crpistillo/ProyectoDCE/README.md

# ProyectoDCE

Los archivos correspondientes a la Primera entrega: TP1 - Etapa de control se encuentran en el directorio *PROYECTO_ETAPA_CONTROL*
