crpistillo/ProyectoDCE/PRACTICAS/P-2 Ejercicio fuente conmutada/P_2_DCE.pdf

Universidad de Buenos Aires

Facultad de Ingeniería

1

er Cuatrimestre 2019

Diseno de Circuitos Electr ˜ | onicos (86.10) ´

## Actividad 2

Tema: Fuentes Conmutadas
Fecha: 8 de mayo de 2020

Grupo 4 - Integrantes:

Apellido y Nombre | Padrón | Correo Electrónico
Galli, Joaquin | 99793 | jgalli@fi.uba.ar
Pereyra, Matias Nicolas | 99362 | mnpereyra@fi.uba.ar
Pistillo, Carolina Rocío | 99177 | cpistillo@fi.uba.ar
Scharn, Ignacio | 98399 | ischarn@fi.uba.ar

Resumen
El objetivo de esta actividad fue estudiar tanto analíticamente como por simulación el comportamiento de un circuito que implementa fuentes conmutadas. Se deseará en particular determinar la tensión sobre el capacitor a la salida en régimen permanente. Finalmente se compararon los resultados obtenidos mediante ambos métodos.

## 1. Circuito propuesto

Para el circuito de la Figura 1 se desea determinar la tensión sobre el capacitor C1 en régimen permamente. Se considerarán C1 y L1 inicialmente descargados y se despreciarán las caídas de tensión en R1 a R5 y en RDS.

Es interesante notar también que la corriente promedio en el inductor durante su energizado disminuirá a medida que crece la tensión en el capacitor C1 debido a que la tensión efectiva aplicada al inductor (durante su energizado) siempre será V 1 − V C1. También disminuirá el tiempo de descarga de la energía del inductor a medida que va aumentando la tensión VC1 en el capacitor por lo que el circuito comienza operando en modo continuo y gradualmente va pasando al modo discontinuo.

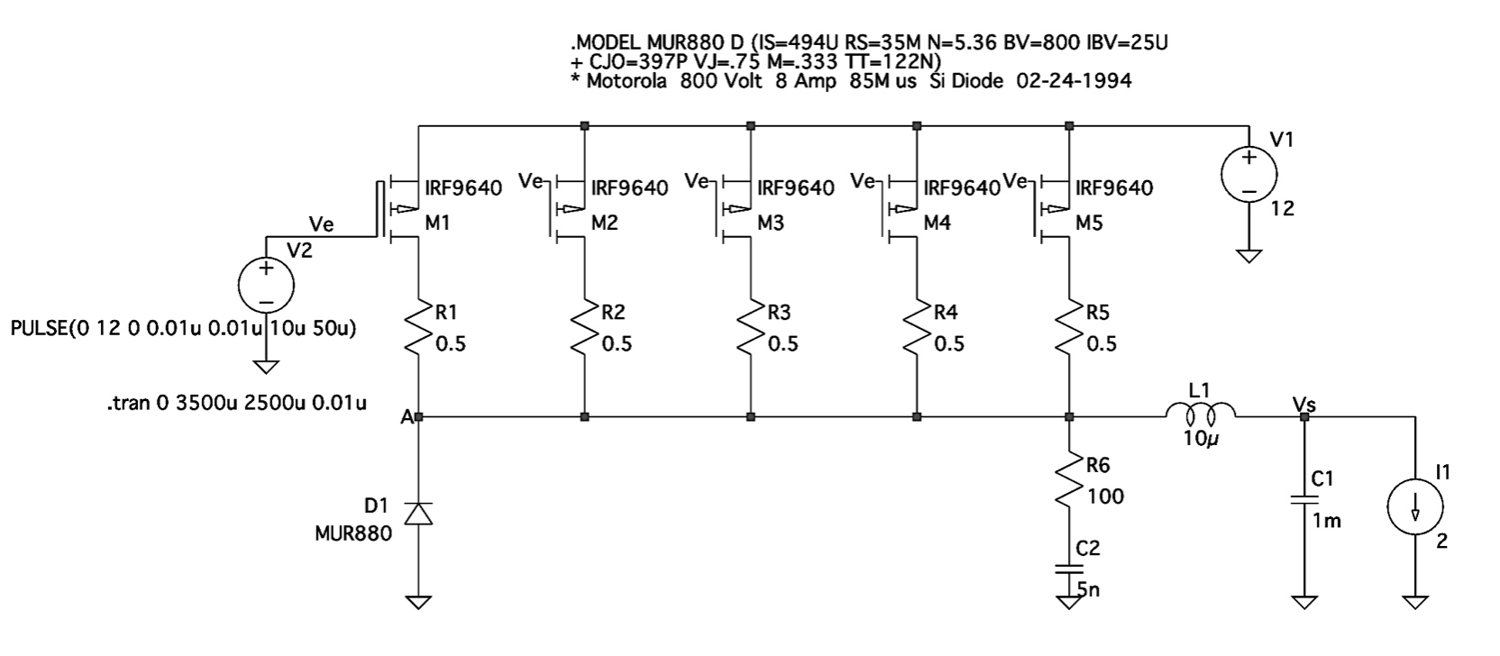
[picture p28: figure]

Figura 1: Simulación del circuito propuesto de fuentes conmutadas realizado en LTspice

Para la corriente sobre el diodo D1 se tendrá en cuenta la Figura 2 que muestra dicho valor en función de la tensión para el modelo MUR880.

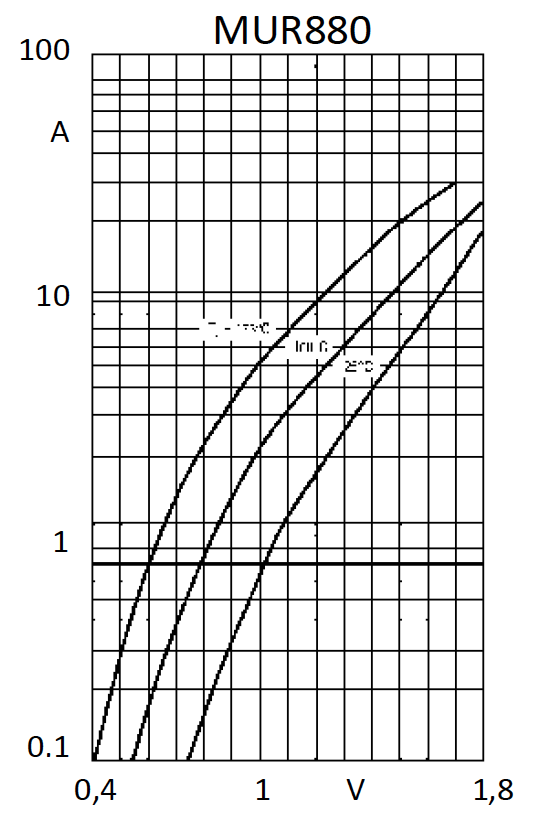
[picture p29: figure]

Figura 2: Curva I-V para el modelo de diodo MUR880

1

## 2. Análisis circuital

A continuación se procederá a analizar el circuito durante los dos estados de conmutación posibles del mismo.

Llave 1 cerrada y llave 2 abierta

Cuando la tensión del generador esta en 0 V, la tensión VGS de los P-MOSFET será de -12 V. Esto los coloca en saturación y hace que se comporten como llaves cerradas, permitiendo el paso de los 12 V al nodo de Drain. Despreciando las caídas de tensión de R1 a R5 podemos suponer que en el nodo A habrá también 12 V. Esto deja al diodo D1 en inversa y por lo tanto no conduciendo en la primera parte del ciclo.

La corriente en la inductancia L1 comienza a elevarse cargando al inductor durante la primer parte del ciclo, llegando a un valor ILmax

. Como se sabe que el circuito termina operando en modo discontinuo, la corriente mínima en el inductor será ILmin = 0A. El capacitor C1 = 1mF tiene un valor que hará que tarde en cargarse y no permita que se lleve corriente. Puede considerarse de esta forma una corriente promedio sobre el inductor igual al valor de la fuente de corriente de 2 A.

Cuando la llave 1 esta cerrada y la llave 2 (diodo) abierta, se llega a la siguiente ecuación sobre la corriente en el inductor:

ILmax = ILmin +

(VE − VS)∆t1
L

(1)

Llave 2 cerrada y llave 1 abierta

Cuando la tensión del generador alcanza los 12 V, la tensión VGS de los P-MOSFET pasa a ser 0 V, co-locándolos en corte y haciendo que se comporten como llaves abiertas. Esto hace que ya no llegue tensión de entrada al nodo A, pero la inductancia sigue teniendo corriente. Como el diodo D1 estaba abierto, el nodo A queda puesto a una impedancia infinita y aparece una tensión en ese nodo que tendería a ir a −∞ pero al alcanzar el valor −VD pone al diodo en directa y se fija en ese valor. Este valor VD con el que se enciende el diodo se corresponderá en el gráfico de la Figura... a un valor de corriente promedio de 2A. Se tendrá entonces que VD es aproximadamente 1,1 V.

El diodo se comportará entonces como una llave que se dispara sola en la segunda parte del ciclo y la inductancia comenzará a descargarse a tensión constante. Cuando la llave 1 esta abierta y la llave 2 (diodo) esta cerrada, se llega a la siguiente ecuación sobre la corriente en el inductor:

ILmin = ILmax −

VS∆t2
L

(2)

El valor promedio de la corriente en el inductor está definido por la integral:

I =

Z T

0

i(t)dt

Dado que el inductor se carga a tensión constante, su corriente tendrá una forma triangular cuyo área bajo la curva puede calcularse fácilmente y la formula anterior se traduce a:

I =

Area
T

I =

ILmax
T

∆t1 + ∆t2
2

ILmax =

2 · I · T
∆t1 + ∆t2

(3)

Tomando la Ecuación (2) y teniendo en cuenta que para el caso discontinuo ILmin = 0A, se tiene que:

2

ILmax =

VS∆t2
L

(4)

Esta última ecuación puede expresarse en términos de VE si se recuerda que VS = VE

∆t1
∆t1+∆t2

:

ILmax =

VE · ∆t1∆t2
L · (∆t1 + ∆t2)

(5)

Igualando las expresiones de las Ecuaciones (3) y (5) se llega a:

4A · T =

VE · ∆t1 · ∆t2
L

Como los parámetros T, VE y L son de valores conocidos, se despeja en función de los mismos y se obtiene que:

∆t2 =

2 · I · T · L
VE · ∆t1

Reemplazando este valor obtenido en (3):

ILmax =

2 · I · T
∆t1 +

4A·T·L
VE·∆t1

ILmax =

2 · I · T
∆t1(1 + 4A·T·L
VE

)

(6)

Finalmente, igualando (6) y (1) se logra despejar el valor de VS en función de ∆t1:

VS =

−1
∆t

2/1(

1
2·I·T·L

+

1
VE

)

+ VE

Reemplazando por los valores conocidos se tiene que:

VS =

−1
∆t

2/1· 500MV ⁻¹

+ 12V | (7)

## 3. Simulación

En esta sección se presentan algunos resultados obtenidos por medio de la simulación del circuito de la Figura 1 mediante la herramienta LTspice.

En los siguientes gráficos se observa que el circuito se encuentra en modo discontinuo y de los puntos marcados pueden deducirse los valores del tiempo de carga ∆t1, el tiempo de descarga ∆t2 y el periodo T de la corriente en el inductor.

3

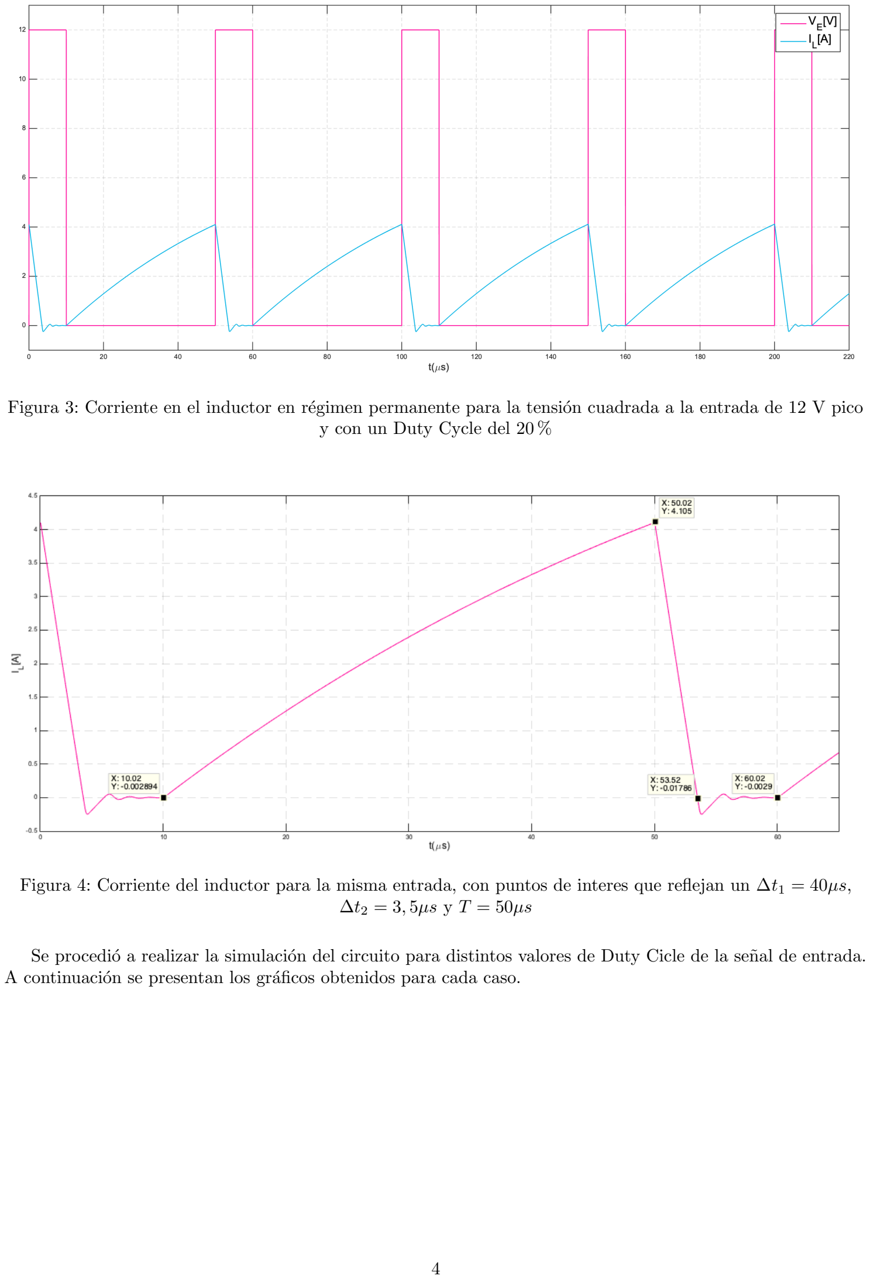
[picture p30: page 5]

Figura 3: Corriente en el inductor en régimen permanente para la tensión cuadrada a la entrada de 12 V pico y con un Duty Cycle del 20 %

Figura 4: Corriente del inductor para la misma entrada, con puntos de interes que reflejan un ∆t1 = 40µs, ∆t2 = 3, 5µs y T = 50µs

Se procedió a realizar la simulación del circuito para distintos valores de Duty Cicle de la señal de entrada. A continuación se presentan los gráficos obtenidos para cada caso.

4

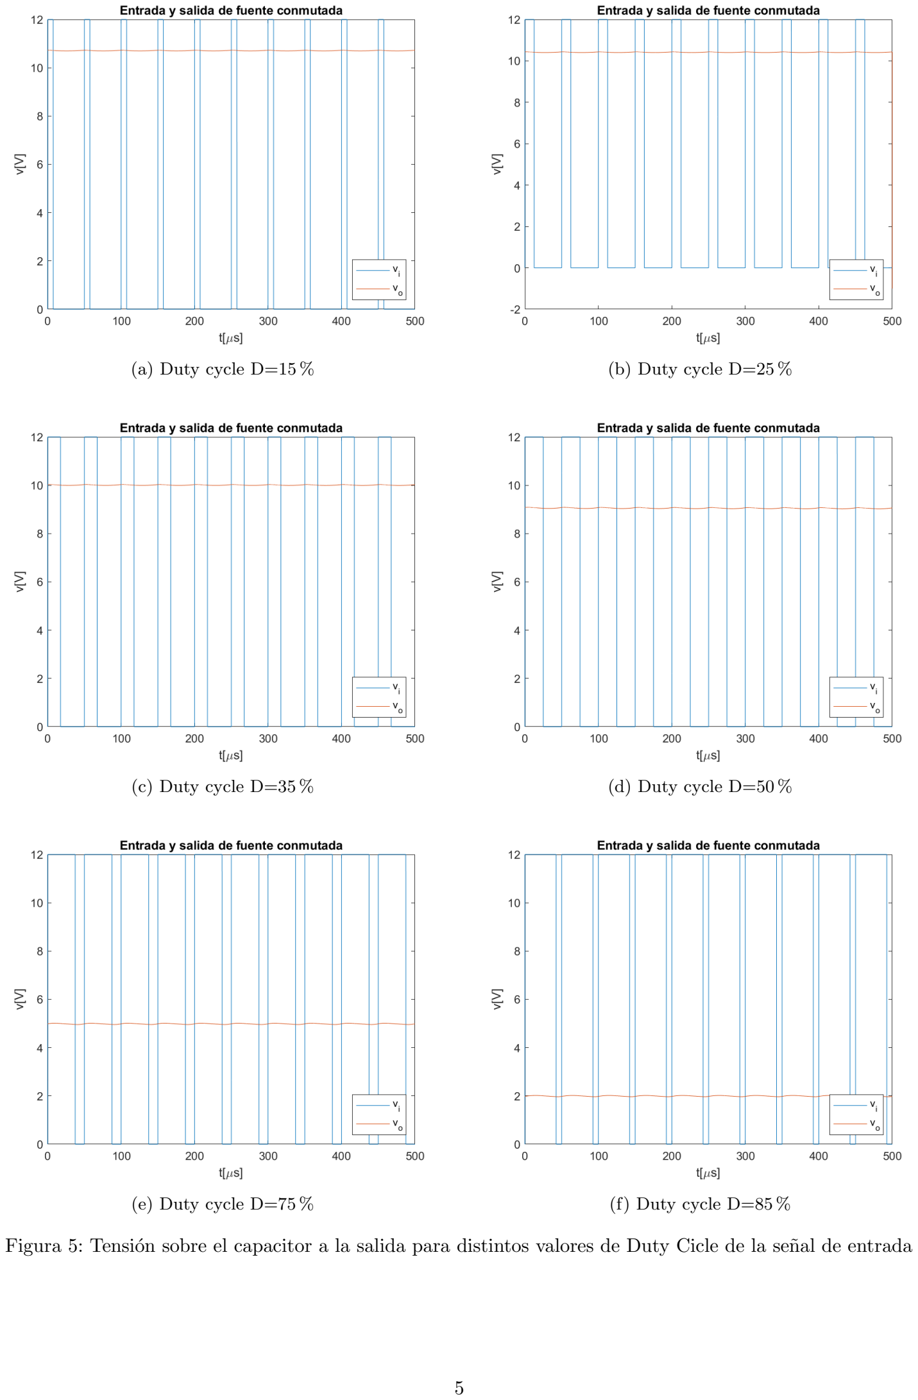
[picture p31: page 6]

(a) Duty cycle D=15 % | (b) Duty cycle D=25 %
(c) Duty cycle D=35 % | (d) Duty cycle D=50 %
(e) Duty cycle D=75 % | (f) Duty cycle D=85 %

Figura 5: Tensión sobre el capacitor a la salida para distintos valores de Duty Cicle de la señal de entrada

5

## 4. Análisis de resultados

Se calcularon además analíticamente los valores de la tensión a la salida VS a partir de la Ecuación (7) para poder observar la relación con los simulados. En el Cuadro 1 se encuentran plasmados los resultados.

D( %) | 15 | 25 | 35 | 50 | 75 | 85
∆t1(us) | 42.5 | 37 | 32.5 | 25 | 12.4 | 7.5
VS simulado(V ) | 10.74 | 10.45 | 10.15 | 9.19 | 5 | 2
VS analitico(V ) | 10.89 | 10.53 | 10.11 | 8.8 | -1 | -23.55

Cuadro 1

Puede observarse que a partir de un 50 % de Duty Cicle los resultados empiezan a diferir sustancialmente. Para valores de Duty Cicle menores que el 50 % sin embargo el comportamiento simulado es muy similar al esperado a partir de los cálculos.

6
