crpistillo/ProyectoDCE/PRACTICAS/Proyecto/Definitivo/triangular_explicada.png

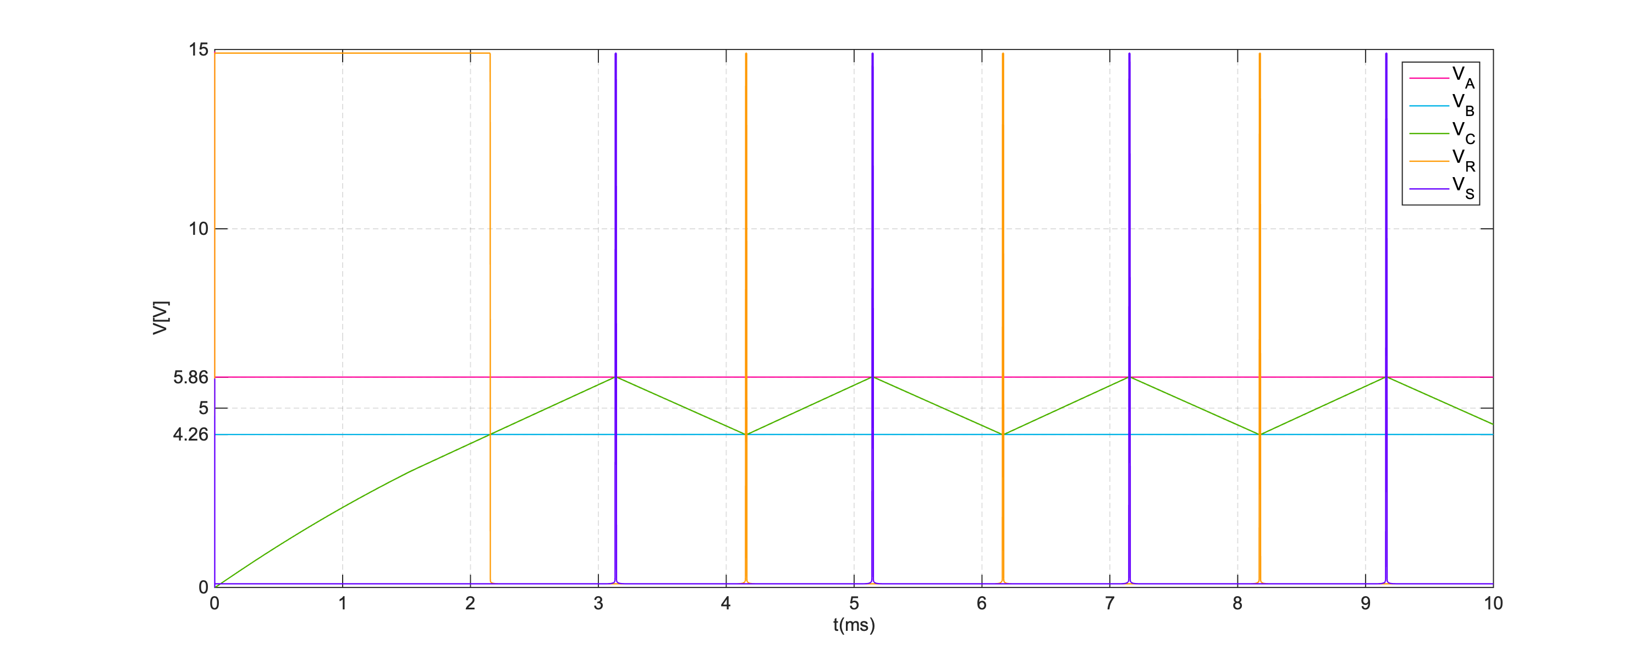
PRACTICAS/Proyecto/Definitivo/triangular_explicada.png
