crpistillo/ProyectoDCE/Kicad/Etapa_de_potencia/modelos/1N750/3D/1N750.stp

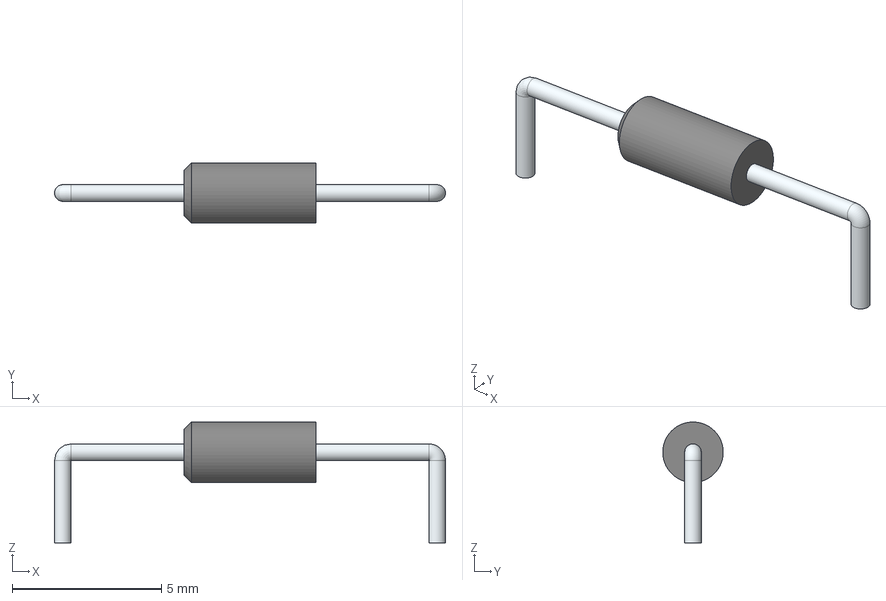
[picture p33: CAD file, 2020-07-23]
Kicad/Etapa_de_potencia/modelos/1N750/3D/1N750.stp
13.1 x 2.03 x 4.06 mm
