crpistillo/ProyectoDCE/Kicad/Etapa_de_potencia/modelos/IRF630/3D/IRF630.stp

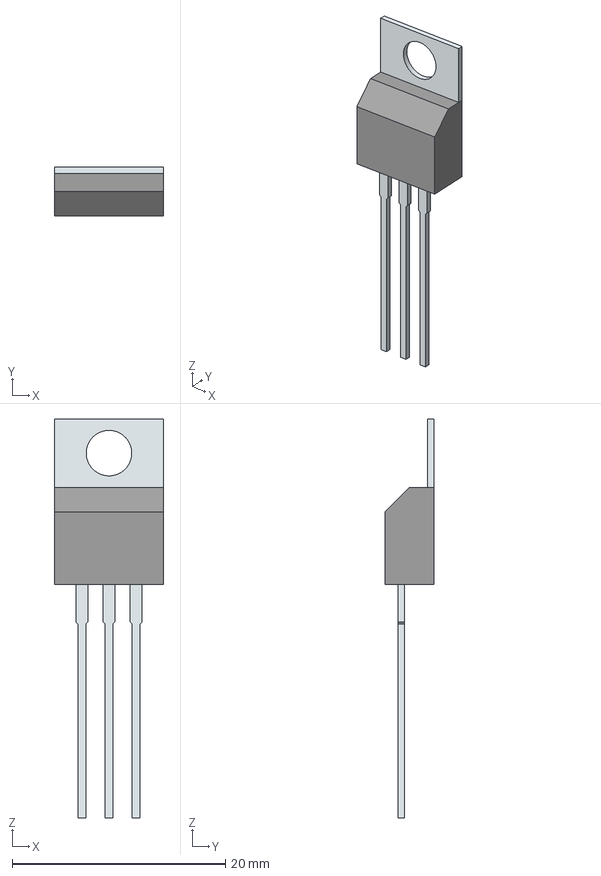
[picture p34: CAD file, 2020-07-23]
Kicad/Etapa_de_potencia/modelos/IRF630/3D/IRF630.stp
10.2 x 4.60 x 37.4 mm
Tab
PinsArray
