crpistillo/ProyectoDCE/Kicad/Etapa_de_potencia/modelos/MUR460G/3D/MUR460G.stp

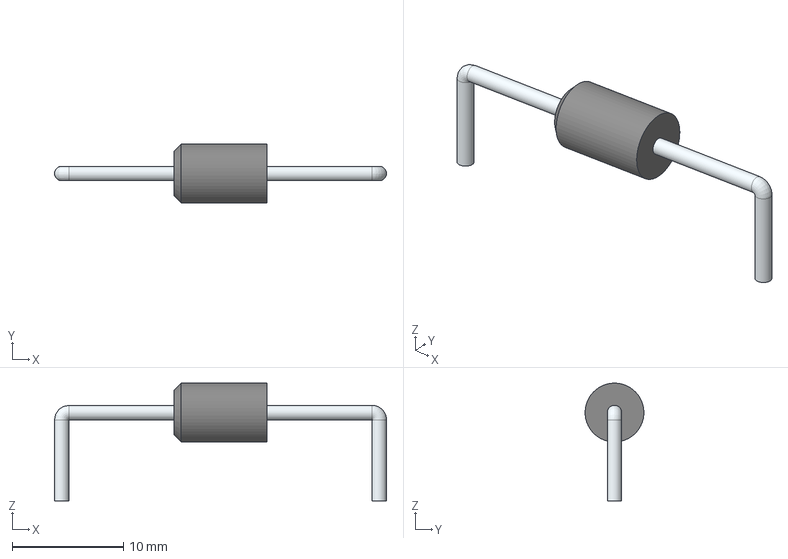
[picture p35: CAD file, 2020-07-23]
Kicad/Etapa_de_potencia/modelos/MUR460G/3D/MUR460G.stp
29.9 x 5.30 x 10.6 mm
