crpistillo/ProyectoDCE/Kicad/Etapa_de_potencia/modelos/NSPW500BS/3D/NSPW500BS.stp

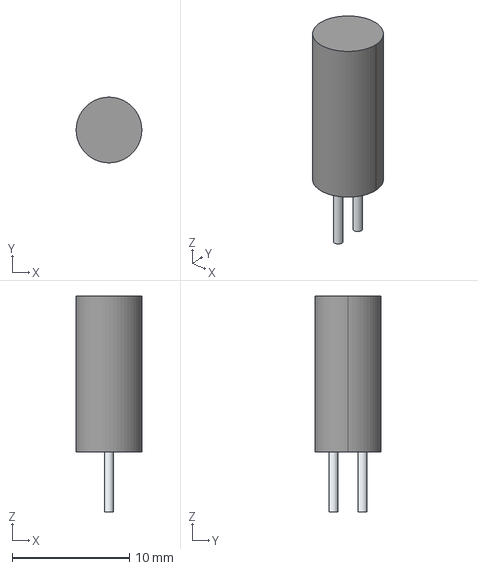
[picture p36: CAD file, 2020-07-23]
Kicad/Etapa_de_potencia/modelos/NSPW500BS/3D/NSPW500BS.stp
5.60 x 5.60 x 18.4 mm
Leads x 2
