crpistillo/ProyectoDCE/(list of files, cad)

Other CAD files:
Kicad/Etapa_de_potencia/modelos/1N750/3D/1N750.stl
Kicad/Etapa_de_potencia/modelos/1N750/Allegro/dioad1256w56l444d203.psm
Kicad/Etapa_de_potencia/modelos/1N750/DEHDL/1n750/chips/chips.prt
Kicad/Etapa_de_potencia/modelos/IRF630/3D/IRF630.stl
Kicad/Etapa_de_potencia/modelos/IRF630/Allegro/to255p460x1020x2008-3p.psm
Kicad/Etapa_de_potencia/modelos/IRF630/DEHDL/irf630/chips/chips.prt
Kicad/Etapa_de_potencia/modelos/MUR460G/3D/MUR460G.stl
Kicad/Etapa_de_potencia/modelos/MUR460G/Allegro/dioad2860w130l840d505.psm
Kicad/Etapa_de_potencia/modelos/MUR460G/DEHDL/mur460g/chips/chips.prt
Kicad/Etapa_de_potencia/modelos/NSPW500BS/3D/NSPW500BS.stl
Kicad/Etapa_de_potencia/modelos/NSPW500BS/Allegro/nspw500bs.psm
Kicad/Etapa_de_potencia/modelos/NSPW500BS/DEHDL/nspw500bs/chips/chips.prt
