crpistillo/ProyectoDCE/(threads)

Thread 23 (2022-01-18):

Agregar un diagrama en bloques mas detallado como el de Ale

crpistillo, 2022-01-18:

crpistillo, 2022-01-23:
Avisen que les parece [esta slide ](https://docs.google.com/presentation/d/127grHv9Y2VIfs35NOMBtJQZpIJnoqGujH9gDhAi3xmE/edit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). Diagrama original: https://drive.google.com/file/d/1ZRlJemULMT2v-FN1eHKtduZh1mF4CASa/view?usp=sharing

@matipereyra7 @JoacoGalli @nachoscharn

Tambien agregue notas de orador

JoacoGalli, 2022-01-25:
@crpistillo agregaria quizas la fuente de -5 cuando pusiste la de 5 y 15? para alimentar a los opamps

Thread 24 (2022-01-18):

Agregar esquematico completo como el de Ale

crpistillo, 2022-01-18:

crpistillo, 2022-01-23:
Esquematico en [esta slide](https://docs.google.com/presentation/d/127grHv9Y2VIfs35NOMBtJQZpIJnoqGujH9gDhAi3xmE/edit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)
verifiquen si esta bien @matipereyra7 @nachoscharn @JoacoGalli

No sabia si poner lo del regulador ahi, y faltaria poner lo de la generacion de los -5V o ver que hacemos con eso

JoacoGalli, 2022-01-25:
@crpistillo yo agregaria una diapo despues de solo reguladores y lo que llevan/necesitan

Thread 39 (2022-01-20):

Arreglar el circuito para que la cuadrada y la triangular tengan la misma amplitud

crpistillo, 2022-01-20:

crpistillo, 2022-01-20:
Propuesta de resolucion:

**Triangular**

Cambio las R1 y R2 para tener una diferencia de tension de 1,2 - 1,4 V entre Vref y A y B  y cambio la resistencia de realimentacion del ultimo opamp a 7.2k para obtener una tension pico a pico a la salida de 2V
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

**Cuadrada**
Cambio el valor de R16 para tener una tension de 2V pico a pico a la salida

crpistillo, 2022-01-20:
Resultados obtenidos:
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

Tension pico a pico triangular: 2.025 V
Tension pico a pico cuadrada: 2.05 V

Thread 40 (2022-01-20):

Arreglar el circuito para que a la salida de la etapa de control se tenga una señal de 0 a 2 V como maximo, con DC y ganancia REGULABLES

crpistillo, 2022-01-20:

Thread 44 (2022-01-23):

Necesitamos 2 potenciometros para R1 y R2 para nivelar los niveles alto y bajo

crpistillo, 2022-01-23:

crpistillo, 2022-01-23:
@matipereyra7 @JoacoGalli @nachoscharn Acabo de subir un nuevo esquematico en la etapa de control (branch [circuitoandando](https://github.com/crpistillo/ProyectoDCE/tree/circuitoandando)) y le puse un pote a R1 y a R2 porque R2 nivela el nivel de tension superior y tambien puede no llegar a ser el deseado. Lo que no se es si poner un pote de 1k o de 2k. Con 1k nos arriesgamos a a penas tener menor amplitud ahi pero tal vez es mas preciso que poner uno de 2k

Thread 45 (2022-01-25):

Eleccion de componentes ETAPA CONTROL

JoacoGalli, 2022-01-25:
Hay que hacer diapo de eleccion de componentes, con los que se usan en el PCB y por que la eleccion de cada componente

JoacoGalli, 2022-01-29:
@crpistillo @matipereyra7  tendriamos que agregar las resitencias y el capacitor a esta tabla no? tipo que son smd o eso
