crpistillo/ProyectoDCE/PROYECTO_ETAPA_CONTROL/StepUp_ideal.asc

R1: res; 10
Rin: res; 400
Step1: sw; RelaySwitch3
V_: voltage; 35
Named nets: IN, OUT, 0
.MODEL RelaySwitch3 SW(Ron=1 Roff=10Meg Vt= 5V)
Modela un regulador step up
Vin = minimo 5V (para optimo funcionamiento; no se modela tension maxima)
Vout = 35V
