crpistillo/ProyectoDCE/PROYECTO_ETAPA_CONTROL/pruebaMiRegDePotencia.asc

R1: res; {X}
V1: voltage; 60
X1: RegDePotencia
Named nets: 0
.step param X list 2 5 10 20 50
.dc V1 30 60 0.1
Con 50ohm anda bien. 20 ya no
