crpistillo/ProyectoDCE/PROYECTO_ETAPA_CONTROL/pruebaMiLM7815.asc

R1: res; {X}
V1: voltage; 23
X1: LM7815
Named nets: 0
.tran 1
Para 15V a la salida, meter 23V aprox.
OBS: meter mas tension a la entrada
puede empeorar la salida
.step param X list 1k 500 100 10 8 5 3
No se banca cargas muy grandes
(resistencias muy chicas).
