crpistillo/ProyectoDCE/ETAPA_POTENCIA/CIRCUITO FINAL PROLIJO/IRS20954_test.asc

?: IRS20954
C1: cap; 10p
C2: cap; 1n
C3: cap; 1n
V1: voltage; PULSE(0 3.7 1u 1n 1n 1u 4u)
V2: voltage; 15
V3: voltage; PULSE(0 3 12u 1n 1n 3u 1m)
V4: voltage; 1.2
V5: voltage; 15
Named nets: 0, DT, Ho, Lo, In, 15V, CsH, CSD, Vref, OCset
Vb Zos: 220V
VddZos: 210V
VccZ: 20.2V
Vb Z: 20.2V
VddZ: 10.4V
Td on: 90ns+Tdt
Td off: 90ns
Tsd:  < 1us
Tr on: 15ns
Tf off: 10ns
Tdt: 15/25/35/45ns
Vdt: .89/.57/.36/.23
VHin: 2.3
VLin: 1.5
VHsat: 1.2
Ros: 5e6
Rb: 12k
Rcc: 7k
Rdd: 22k
Rin: 1e6
UVL Vcc: 8.9/8.7V
UVL Vb:  8.5/8.3V
UVL Vdd: 8.7/8.2V
Io+: 1.0A
Io-: 1.2A
Voc: 70/30 %Vdd
Ioc: +/-100ua
OCH: 1.2Vos
 300ns filter
OCL: 0.0Vos
 200ns filter
.tran 0 30u 0 10n uic
.options plotwinsize=0
