crpistillo/ProyectoDCE/Onda cuadrada - pruebas/LM555/LM555.asc

C1: cap; 0.01µ
C: cap; 0.01µ
R1: res; 20k
R2: res; 20k
RA: res; 3.9k
RB: res; 3k
U1: UA555
V1: voltage; 5
Named nets: 0, Vcc
.tran 0 2.5m 2m 0.01m
