crpistillo/ProyectoDCE/ETAPA_CONTROL.asc

C1: cap; 200n
C2: cap; 0.1µ
C3: cap; 0.01µ
C4: cap; 1n
M1: nmos; 2N7000
M2: nmos; 2N7000
M3: pmos
Q1: pnp; 2N3906
Q2: pnp; 2N3906
Q3: npn; 2N3904
Q4: npn; 2N3904
Q5: npn; 2N3904
Q6: npn; 2N3904
Q7: npn; 2N3904
Q8: npn; 2N3904
Q9: pnp; 2N3906
Q10: pnp; 2N3906
R1: res; 500
R2: res; 500
R3: res; 10k
R4: res; 3k
R5: res; 3k
R6: res; 10k
R7: res; 35k
R8: res; 10k
R9: res; 10k
R10: res; 100
R11: res; 100
R12: res; 50k
R13: res; 50k
R14: res; 40k
R15: res; 20k
R16: res; 10k
R17: res; 150k
R18: res; 50k
R19: res; 100k
R20: res; 18k
R21: res; 10k
R22: res; 10k
R23: res; 10k
R24: res; 10k
R25: res; 10k
R26: res; 10k
R27: res; 90k
R28: res; 10k
R29: res; 10k
R30: res; 10k
R31: res; 10k
RL: res; 10k
U1: opamp2; LM393
U2: opamp2; LM393
U3: opamp2; TL084
U4: opamp2; TL084
U5: opamp2; TL084
U6: opamp2; TL084
U7: opamp2; TL084
U8: SN74HC02
U9: SN74HC02
U10: opamp2; TL084
U11: opamp2; TL084
U12: opamp2; TL084
U13: TL074
U14: TL074
V1: voltage; -15
V2: voltage; 15
V3: voltage; -5
V4: voltage; 5
V5: voltage; -5
V6: voltage; 15
Vin1: voltage; SINE(14 0.1 500)
Named nets: 0, Vcc, Vcc5, VS, VR, Vc, VQ, not_VQ, Vss, Vcc-5, Vin, A, B, Vo_cuadrada, Vo, Vo_triangular, DC, -15, 15, Vo2
Generador - Primera Etapa
Generador - Segunda Etapa
.tran 0 25m 20m 0.1m uic
.include TL084.301
.include LM393.5_1
Triangular centrada
Cuadrada centrada
Sumador
Flip flop RS
.include 2N7000.lib
Continua
;tran 1m
