crpistillo/ProyectoDCE/PROYECTO_ETAPA_CONTROL/PWM.asc

C1: cap; 200n
C2: cap; 0.1µ
C3: cap; 0.01µ
C4: cap; 100n
C5: cap; 100n
C6: cap; 100n
C7: cap; 0.5n
C8: cap; 100n
M1: nmos; 2N7000
M2: nmos; 2N7000
M3: pmos
Q1: pnp; 2N3906
Q2: pnp; 2N3906
Q3: npn; 2N3904
Q4: npn; 2N3904
Q5: npn; 2N3904
Q6: npn; 2N3904
Q7: npn; 2N3904
Q8: npn; 2N3904
Q9: pnp; 2N3906
Q10: pnp; 2N3906
R1: res; 500
R2: res; 500
R3: res; 10k
R4: res; 3k
R5: res; 3k
R6: res; 10k
R7: res; 35k
R8: res; 10k
R9: res; 10k
R10: res; 100
R11: res; 100
R12: res; 50k
R13: res; 50k
R14: res; 40k
R15: res; 20k
R16: res; 10k
R17: res; 150k
R18: res; 50k
R19: res; 100k
R21: res; 50k
R24: res; 10k
R25: res; 10k
R26: res; 10k
R27: res; 50k
R28: res; 50k
R29: res; 50k
R30: res; 50k
R31: res; 50k
RF1: res; 50k
RL: res; 10k
U1: opamp2; LM393
U2: opamp2; LM393
U3: opamp2; TL084
U4: opamp2; TL084
U5: opamp2; TL084
U6: opamp2; TL084
U7: opamp2; TL084
U8: SN74HC02
U9: SN74HC02
U10: opamp2; TL084
U11: opamp2; TL084
U14: opamp2; TL084
V1: voltage; 6
V2: voltage; 15
V3: voltage; -5
V4: voltage; 5
V5: voltage; -5
Vin1: voltage; SINE(14 0.1 500)
X1: LM7815
X2: RegDePotencia
X3: Relay
X4: StepUp_ideal
X5: LM7805
Named nets: 0, Vcc5, VS, VR, Vc, VQ, not_VQ, Vcc, Vss, Vcc-5, Vin, A, B, Vo_cuadrada, Vo_triangular, DC, V_7815, Vo, Vosc, V_7805
Generador - Primera Etapa
Generador - Segunda Etapa
.tran 0 22.5m 20m 0.1m uic
.include TL084.301
.include LM393.5_1
Triangular centrada
Cuadrada centrada
Flip flop RS
.include 2N7000.lib
Continua
Bloque regulador de tensión
Oscilador y comparador
