crpistillo/ProyectoDCE/PROYECTO_ETAPA_CONTROL/LM7805.asc

C1: cap; 20p
D1: zener; 6.3V
D2: zener; DZ
Q1: NPN; NP
Q2: npn; NP
Q3: npn; NP
Q4: PNP; PN
Q5: npn; NP
Q6: npn; NP
Q7: npn; NP
Q8: npn; NP
Q9: npn; NP
Q10: npn; NP
Q11: npn; NP
Q12: npn; NP
Q13: npn; NP
Q14: npn; NP
Q15: npn; NP
Q16: pnp; PN
Q17: pnp; PN
Q18: pnp; PN
R1: RES; .3
R2: res; 2K
R3: res; {Rx}
R4: res; 2.6K
R5: res; 4K
R6: res; 1K
R7: res; 4K
R8: res; 1K
R9: res; 17K
R10: res; 12.1K
R11: res; 200
R12: res; 3.4K
R13: res; 26
R14: res; 1.9K
R15: res; 1.2K
R16: res; 30K
R17: res; 230
R18: res; 10K
Named nets: OUT, IN, Ground
.model 6.3V D(BV=6.3)
.model DZ D(BV=3.5)
.model NP NPN(BF=125 Cje=.5p Cjc=.5p Rb=500)
.model PN LPNP(BF=25 Cje=.3p Cjc=1.5p Rb=250)
.param Rx 905 ; 5V
;.param Rx 5.78K ; 12V
;.param Rx 7.87K ; 15V
This example schematic is supplied for informational/educational purposes only.
;.step param Rx list 905 5.78K 7.87K
