crpistillo/ProyectoDCE/PROYECTO_ETAPA_CONTROL/Relay.asc

D1: zener; D1N4735
D2: zener; D1N4735
D3: zener; D1N4735
D4: diode; 1N4148
D5: diode; 1N4148
D6: diode; 1N4148
D7: diode; 1N4148
R1: res; 2.7k
Step1: sw; RelaySwitch
Step2: sw; RelaySwitch2
Named nets: 0, IN, LOW, HIGH
Zener de 6.2
.MODEL RelaySwitch SW(Ron=10 Roff=1Meg Vt=12V)
.include D1N4735.LIB
.MODEL RelaySwitch2 SW(Ron=10 Roff=1Meg Vt=-12V)
Diodos de 0.6V
