crpistillo/ProyectoDCE/PROYECTO_ETAPA_CONTROL/RegDePotencia.asc

D2: zener; D1N4735
Q1: npn; BD681
Q6: npn; 2N3904
Q10: npn; 2N3904
R1: res; 27k
R2: res; 10k
R9: res; 2k
R10: res; 2k
R14: res; 26
R15: res; 10k
Named nets: 0, OUT, IN, ground
;tran 20m
.include D1N4735.LIB
.include BD681.LIB
