crpistillo/ProyectoDCE/Integrador no inversor con LM741/integ_no_inv_LM741.asc

C1: cap; 0.1µ
R1: res; 10k
R2: res; 10k
R3: res; 10k
R4: res; 10k
R5: res; 1k
U1: LM741_NS
V1: voltage; 20
V2: voltage; -20
V3: voltage; PULSE(0 1 100u 1n 1n 50u 100u 1)
V4: voltage; PULSE(-0.1 0.1 10m 1n 1n 10m 20m)
Named nets: 0, V+, V-
.tran 0 5000m 0 0.1m
