crpistillo/ProyectoDCE/TP1/Onda Cuadrada Ejemplo 16-1.asc

R1: res; 6.43k
R2: res; 10k
R3: res; 18k
R4: res; 10k
R5: res; 0.5k
U1: LM111
V1: voltage; SINE(0 10 400)
V2: voltage; 15
V3: voltage; -15
Named nets: 0, v+, v-
.tran 0 20m 0 1u
