crpistillo/ProyectoDCE/TP1/Onda Cuadrada Ejemplo 16-3.asc

C1: cap; 0.01µ
R1: res; 10k
R: res; 10k
Rf: res; 11.6k
RL: res; 10k
Rp: res; 0.5k
U1: LM111
V1: voltage; 15
V2: voltage; -15
Named nets: 0, -, +
.tran 0 900u 0 1u uic
;.ic V(n001)=0.25
