crpistillo/ProyectoDCE/ETAPA_POTENCIA/CIRCUITO FINAL PROLIJO/FINAL FILTRO_con_limitador.asc

C1: cap; 22n
C2: cap; 22n
C3: cap; {C_1}
C4: cap; {C_2}
C5: cap; 1µ
C6: cap; 100n
C8: cap; 1000µ
C9: cap; 1n
C10: cap; 1n
C11: cap; 100p
Cp: cap; {Cp}
Ct1: cap; 10p
D1: diode; 1N4448
D2: diode; BAV21
D3: LED; NSPW500BS
D4: diode; 1N4148
D5: zener; 1N750
D6: diode; MUR460
D7: diode; MUR460
L1: ind; 2m
M1: nmos; irf510
M2: nmos; irf510
Q1: npn; BC547B
Q2: pnp; BC557B
Q3: pnp; BC557B
R1: res; 10k
R2: res; 6.5k
R3: res; 3.5k
R4: res; 4.6k
R5: res; 5.4k
R6: res; 7.5k
R7: res; 2.5k
R8: res; {Rg}
R9: res; {R_2}
R10: res; {R_1}
R11: res; {R_3}
R12: res; 9k
R13: res; 1k
R14: res; 3k
R15: res; 0.1
R23: res; {Rg}
R24: res; {Rg}
R25: res; 9k
R26: res; 1k
R27: res; 90k
R28: res; 90k
R29: res; 100k
R30: res; 10k
R31: res; 1k
R32: res; 15
R33: res; 10k
R34: res; 8.45k
R35: res; 15k
R36: res; 1Meg
RD1: res; 0.1
RG1: res; 22
RG2: res; 22
Rp: res; {Rp}
S2: sw
S3: sw
U3: opamp2; TL084
U4: opamp2; TL084
U5: opamp2; LM393
U6: opamp2; TL084
U7: TLV3501
U8: OPA365
V1: voltage; 0.333
V2: voltage; 15
V3: voltage; PULSE(-4 4 0 2.5u 2.5u 0 5u)
V4: voltage; 60
V5: voltage; 2.5
V6: voltage; 5
V7: voltage; 5
V8: voltage; -5
V9: voltage; 5
V10: voltage; PULSE(0 1 1m 1u 1u 10m 10m 1)
V11: voltage; 40
V12: voltage; 1
X1: IRS20954
Named nets: 0, VDD_60, VDD, Vss, 5V, V_error, Vin, Vo1, Vt, VerrorC, V_limite_C, A, VC, V+, V-, Vosc
Vb Zos: 220V
VddZos: 210V
VccZ: 20.2V
Vb Z: 20.2V
VddZ: 10.4V
Td on: 90ns+Tdt
Td off: 90ns
Tsd:  < 1us
Tr on: 15ns
Tf off: 10ns
Tdt: 15/25/35/45ns
Vdt: .89/.57/.36/.23
VHin: 2.3
VLin: 1.5
VHsat: 1.2
Ros: 5e6
Rb: 12k
Rcc: 7k
Rdd: 22k
Rin: 1e6
UVL Vcc: 8.9/8.7V
UVL Vb:  8.5/8.3V
UVL Vdd: 8.7/8.2V
Io+: 1.0A
Io-: 1.2A
Voc: 70/30 %Vdd
Ioc: +/-100ua
OCH: 1.2Vos
 300ns filter
OCL: 0.0Vos
 200ns filter
.tran 20m uic
.model MUR460 D(Is=149n Rs=.0384 N=2 EG=1.285 XTI=.5 BV=800 
+ IBV=1e-05 Cjo=126.4p Vj=1.34 M=.52 tt=44.4n Iave=4 Vpk=600 mfg=GI type=silicon)
.MODEL BAV21W D  ( IS=1.09u RS=0.105 BV=200 IBV=100n
+ CJO=5.00p  M=0.333 N=3.29 TT=72.0n )
.include LM393.5_1
.include TL084.301
.param Rg=10k
.param R_1=50k R_2=250k R_3=1k C_1=10p C_2=0.15n Rp=200k Cp=1p
.model SW SW(Ron=0.001 Roff=100Meg Vt=0.5 Vh=0.25)
.MODEL BAV21 D  ( IS=1.09u RS=0.105 BV=200 IBV=100n
+ CJO=5.00p  M=0.333 N=3.29 TT=72.0n )
.MODEL 1N4448 D (IS=2.22E-10 N=1.70 BV=1.00E+02 IBV=5.00E-05
+ RS=2.10E-01 CJO=4.00E-12 VJ=.75 M=.333 TT=5.76E-09)
.include irf510.lib.txt
