crpistillo/ProyectoDCE/ETAPA_POTENCIA/CIRCUITO FINAL PROLIJO/Draft1.asc

C1: cap; 22n
C2: cap; 22n
C3: cap; 1n
C4: cap; 1n
Ct1: cap; 10p
D1: diode; MUR460
D2: diode; MUR460
D3: diode; BAV21
D4: diode; 1N4448
M1: nmos; irf510
M2: nmos; irf510
R1: res; 10k
R2: res; 6.5k
R3: res; 3.5k
R4: res; 4.6k
R5: res; 5.4k
R6: res; 7.5k
R7: res; 2.5k
RD1: res; 0.1
RG1: res; 22
RG2: res; 22
X1: IRS20954
Named nets: 0, VDD_60, VDD, Vo1, PWM
