crpistillo/ProyectoDCE/ETAPA_POTENCIA/irs20954/Halfbridge_LAZOCERRADO2_regulador.asc

C1: cap; 22n
C2: cap; 22n
C3: cap; {C_1}
C4: cap; {C_2}
C5: cap; 1�
C6: cap; 100n
C7: cap; 0.5n
C8: cap; 10�
Cp: cap; {Cp}
Ct1: cap; 10p
D1: zener; MUR460
D2: diode; MUR460
D3: LED; NSPW500BS
D4: diode; 1N4148
D5: zener; 1N750
L1: ind; 1m
M1: nmos; irf630
M2: nmos; irf630
Q1: npn; BC547B
Q2: pnp; BC557B
Q3: pnp; BC557B
R1: res; 4.6k
R2: res; 5.4k
R3: res; 10k
R4: res; 4k
R5: res; 6k
R6: res; 8.2k
R7: res; 3.3k
R8: res; {Rg}
R9: res; {R_2}
R10: res; {R_1}
R11: res; {R_3}
R12: res; 9k
R13: res; 1k
R14: res; 3k
R15: res; 2
R16: res; {R}
R17: res; {R}
R18: res; {R}
R19: res; {R}
R20: res; {R}
R21: res; {R}
R22: res; 3k
R23: res; {Rg}
R24: res; {Rg}
R25: res; 9k
R26: res; 1k
R27: res; 90k
R28: res; 90k
R29: res; 0.1
R30: res; 100k
R31: res; 10k
R32: res; 1k
RD1: res; 10
RF1: res; {R}
RG1: res; 2.2
RG2: res; 2.2
Rp: res; {Rp}
U1: opamp2; TL084
U2: opamp2; LM393
U3: opamp2; TL084
U4: opamp2; TL084
U5: opamp2; LM393
U6: UniversalOpamp2; Avol=1Meg GBW=100000Meg Slew=100000Meg
V1: voltage; 2.5
V2: voltage; 15
V4: voltage; 60
V5: voltage; PULSE(0 0.5 0 1n 1n 1m 2m)
V7: voltage; 5
V8: voltage; -5
V11: voltage; PULSE(-0.1 0.1 0.06m 1m 1m 0 2m)
V12: voltage; PULSE(0 0.2 16.06m 0.01u 0.01u 1)
X1: IRS20954
Named nets: 0, VDD_60, VDD, Vss, 5V, VoscComp, V_error, Vin, Vo1, Vo, VerrorC, 15V, -15V, V_limite_C, A
Vb Zos: 220V
VddZos: 210V
VccZ: 20.2V
Vb Z: 20.2V
VddZ: 10.4V
Td on: 90ns+Tdt
Td off: 90ns
Tsd:  < 1us
Tr on: 15ns
Tf off: 10ns
Tdt: 15/25/35/45ns
Vdt: .89/.57/.36/.23
VHin: 2.3
VLin: 1.5
VHsat: 1.2
Ros: 5e6
Rb: 12k
Rcc: 7k
Rdd: 22k
Rin: 1e6
UVL Vcc: 8.9/8.7V
UVL Vb:  8.5/8.3V
UVL Vdd: 8.7/8.2V
Io+: 1.0A
Io-: 1.2A
Voc: 70/30 %Vdd
Ioc: +/-100ua
OCH: 1.2Vos
 300ns filter
OCL: 0.0Vos
 200ns filter
.tran 10m
.include irf630.lib.txt
.model MUR460 D(Is=149n Rs=.0384 N=2 EG=1.285 XTI=.5 BV=800 
+ IBV=1e-05 Cjo=126.4p Vj=1.34 M=.52 tt=44.4n Iave=4 Vpk=600 mfg=GI type=silicon)
.MODEL BAV21W D  ( IS=1.09u RS=0.105 BV=200 IBV=100n
+ CJO=5.00p  M=0.333 N=3.29 TT=72.0n )
.params R=15k
Con 15kOhm consigo 100k
.include LM393.5_1
.include TL084.301
;step param RL list 20 1k
Siempre uno comentado y el otro no:
;.tran 0 32.1m 0.1m
Con: R7=8.2k, R6=3.3k (dead time=15ns)
Con: R7=2.2k y R6=5.7k (dead time=35ns)
L=250u --> si RL=400m, f0=360Hz :'(
                  si RL=200, f0=180kHz :'(
Calculo el C para 50Hz, RL=8ohm --> C=1/(w0*RL*sqrt(2))= 280nF
Puse un C mas grande, de 1uF, porque mejora rta
En bajas quiero ganancia tal que se iguale la
amplitud de salida con la de entrada (al nodo)
.param Rg=5k
;.step param Rg list 1k 10k
Rg tipo 5k o 10k, ayuda a 
matar ruido de 10kHz
;.param R_1=100k R_2=900k R_3=1k C_1=100n C_2=0.1n Rp=50k Cp=10p Rs=100k Cs=100p
;.param R_1=500k R_2=100k C_1=100p R_3=10k C_2=100p Rp=100k Cp=10p Rs=1Meg Cs=1p
MF=68.7°, ripple=11mV
;.param R_1=150k R_2=330k R_3=10k C_1=100n C_2=1n Rp=10k Cp=1p Rs=100k Cs=100p
MF=36.2°, ripple=
Satura con 0.7V de entrada
Por abajo, satura a los -0.2V
;.four 0.1kHz 10 20 V(Vc) ;10 armonicos, 20 ciclos
;.options numdgt=7
;.options plotwinsize=0
;param R_1=100k R_2=500k R_3=1k C_1=0.01n C_2=1n Rp=10k Cp=0.001n Rs=100k Cs=100p
;.param R_1=100k R_2=900k R_3=1k C_1=100n C_2=0.1n Rp=50k Cp=10p Rs=100k Cs=100p
;.param R_1=100k R_2=600k R_3=1k C_1=0.01n C_2=1n Rp=10k Cp=0.001n Rs=100k Cs=100p
ESTOY USANDO ESTE
