crpistillo/ProyectoDCE/ETAPA_POTENCIA/irs20954/ganancia inversor.asc

R1: res; {Rg}
R2: res; {Rg}
R3: res; {Rg}
R4: res; 1
U1: opamp2; TL084
V1: voltage; PULSE(-1 1 0 5u 5u 5u 10u)
Named nets: 0, Vss, 5V
.param Rg=3k
;.step param Rg list 1k 10k
.tran 10m
.include TL084.301
