crpistillo/ProyectoDCE/ETAPA_POTENCIA/CIRCUITO FINAL PROLIJO/Circuito de Potencia.asc

C1: cap; 22n
C2: cap; 22n
C3: cap; 1µ
C4: cap; {C_1}
C5: cap; {C_2}
C6: cap; 0.5n
Cp1: cap; {Cp}
Ct1: cap; 10p
D1: zener; MUR460
D2: diode; MUR460
L1: ind; 1m
M1: nmos; irf630
M2: nmos; irf630
R1: res; 10k
R2: res; 5.4k
R3: res; 4.6k
R4: res; 6k
R5: res; 4k
R6: res; 8.2k
R7: res; 3.3k
R8: res; 50
R9: res; {R_2}
R10: res; {R_1}
R11: res; {R_3}
R12: res; 3k
R13: res; {Rg}
R14: res; {Rg}
R15: res; {Rg}
R16: res; {R}
R17: res; {R}
R18: res; {R}
R19: res; {R}
R20: res; {R}
R21: res; {R}
R22: res; 3k
RD1: res; 10
RF1: res; {R}
RG1: res; 20
RG2: res; 20
Rp1: res; {Rp}
U1: opamp2; TL084
U2: opamp2; LM393
U3: opamp2; TL084
U4: opamp2; TL084
U5: opamp2; LM393
V1: voltage; PULSE(0 3.2 0.5m 0.1u 0.1u 1m 2m)
V2: voltage; 15
V3: voltage; 60
V4: voltage; -5
V5: voltage; 5
X1: IRS20954
Named nets: VDD_60, VDD, 0, Vo1, PWM, Vo, V_error, Vss, 5V, VoscComp, Vin
Half-Brige con Gate Driver
Filtro
Bloque realimentador f
.param Rg=10k
Amplificador inversor -1/Rg
Amplificador realimentado por 
corriente con compensador PID
.param Rp=10k Cp=1p
Comparador
.params R=15k
Generador de triangular de precision
Vb Zos: 220V
VddZos: 210V
VccZ: 20.2V
Vb Z: 20.2V
VddZ: 10.4V
Td on: 90ns+Tdt
Td off: 90ns
Tsd:  < 1us
Tr on: 15ns
Tf off: 10ns
Tdt: 15/25/35/45ns
Vdt: .89/.57/.36/.23
VHin: 2.3
VLin: 1.5
VHsat: 1.2
Ros: 5e6
Rb: 12k
Rcc: 7k
Rdd: 22k
Rin: 1e6
UVL Vcc: 8.9/8.7V
UVL Vb:  8.5/8.3V
UVL Vdd: 8.7/8.2V
Io+: 1.0A
Io-: 1.2A
Voc: 70/30 %Vdd
Ioc: +/-100ua
OCH: 1.2Vos
 300ns filter
OCL: 0.0Vos
 200ns filter
.include irf630.lib.txt
.model MUR460 D(Is=149n Rs=.0384 
+ N=2 EG=1.285 XTI=.5 BV=800 
+ IBV=1e-05 Cjo=126.4p Vj=1.34 
+ M=.52 tt=44.4n Iave=4 Vpk=600 
+ mfg=GI type=silicon)
.MODEL BAV21W D  ( IS=1.09u 
+ RS=0.105 BV=200 IBV=100n
+ CJO=5.00p  M=0.333 N=3.29 
+ TT=72.0n )
.include LM393.5_1
.include TL084.301
.tran 1.5m
.param R_1=100k R_2=500k 
+ R_3=1k C_1=0.01n C_2=1n
If
