crpistillo/ProyectoDCE/ETAPA_POTENCIA/irs20954/Halfbridge_caro.asc

C1: cap; 22n
C2: cap; 22n
Ct1: cap; 10p
D1: zener; MUR460
D2: diode; MUR460
M1: nmos; irf630
M2: nmos; irf630
R1: res; 4.6k
R2: res; 5.4k
R3: res; 10k
R4: res; 4k
R5: res; 6k
R6: res; 8.2k
R7: res; 3.3k
RD1: res; 10
RG1: res; 2.2
RG2: res; 2.2
X1: IRS20954
Named nets: 0, VDD_60, VDD, Vo1, Vin
