crpistillo/ProyectoDCE/ETAPA_POTENCIA/irs20954/Halfbridge_con_filtroLC.asc

C1: cap; 22n
C2: cap; 30n
C5: cap; 1µ
C7: cap; 0.5n
Ct1: cap; 10p
D1: zener; MUR460
D2: diode; BAV21W
L1: ind; 33µ
M1: nmos; irf630
M2: nmos; irf630
R1: res; 4.6k
R2: res; 5.4k
R3: res; 10k
R4: res; 4k
R5: res; 6k
R6: res; 3.3k
R7: res; 8.2k
R8: res; 3k
R15: res; {RL}
R16: res; {R}
R17: res; {R}
R18: res; {R}
R19: res; {R}
R20: res; {R}
R21: res; {R}
R22: res; 3k
RD1: res; 10
RF1: res; {R}
RG1: res; 2.2
RG2: res; 2.2
U1: opamp2; TL084
U2: opamp2; LM393
U3: opamp2; LM393
V1: voltage; PULSE(-5 5 0 1n 1n 5u 20u)
V2: voltage; 15
V3: voltage; 15
V4: voltage; 60
V5: voltage; PULSE(-1 1 0.1m 0.1u 0.1u 1m 2m)
V6: voltage; PULSE(5 -5 0 1n 1n 5u 20u)
V7: voltage; 5
V8: voltage; -5
X1: IRS20954
Named nets: 0, VDD1, VDD, Vin1, Vin2, Vo1, Vss, 5V, VoscComp
Vb Zos: 220V
VddZos: 210V
VccZ: 20.2V
Vb Z: 20.2V
VddZ: 10.4V
Td on: 90ns+Tdt
Td off: 90ns
Tsd:  < 1us
Tr on: 15ns
Tf off: 10ns
Tdt: 15/25/35/45ns
Vdt: .89/.57/.36/.23
VHin: 2.3
VLin: 1.5
VHsat: 1.2
Ros: 5e6
Rb: 12k
Rcc: 7k
Rdd: 22k
Rin: 1e6
UVL Vcc: 8.9/8.7V
UVL Vb:  8.5/8.3V
UVL Vdd: 8.7/8.2V
Io+: 1.0A
Io-: 1.2A
Voc: 70/30 %Vdd
Ioc: +/-100ua
OCH: 1.2Vos
 300ns filter
OCL: 0.0Vos
 200ns filter
;.tran 0 4.1m 0.1m
.include irf630.lib.txt
.model MUR460 D(Is=149n Rs=.0384 N=2 EG=1.285 XTI=.5 BV=800 
+ IBV=1e-05 Cjo=126.4p Vj=1.34 M=.52 tt=44.4n Iave=4 Vpk=600 mfg=GI type=silicon)
.MODEL BAV21W D  ( IS=1.09u RS=0.105 BV=200 IBV=100n
+ CJO=5.00p  M=0.333 N=3.29 TT=72.0n )
.ic V(Vo1)=-1
.ic V(Vo2)=-1
.params R=15k
Con 15kOhm consigo 100k
.include LM393.5_1
.include TL084.301
;.step param RL list 400m 200
.param RL=8
Siempre uno comentado y el otro no:
.tran 0 32.1m 0.1m
