crpistillo/ProyectoDCE/ETAPA_POTENCIA/irs20954/Fuente de alimentacion conmutada modo continuo topologia clase D(2).asc

C1: cap; 1µ
C2: cap; 22n
C3: cap; 30n
C6: cap; 10µ
C7: cap; 100p
C8: cap; 1n
C9: cap; 10p
C10: cap; 1n
C11: cap; 100n
Ct1: cap; 10p
D1: diode; MUR460
D2: diode; MUR460
D3: LED; NSPW500BS
D4: diode; 1N4148
D5: zener; 1N750
D6: zener; MUR460
L1: ind; 250µ
M1: nmos; irf6665
M2: nmos; irf6665
Q1: npn; BC547B
Q2: pnp; BC557B
Q3: pnp; BC557B
R1: res; 4.6k
R2: res; 5.4k
R3: res; 10k
R4: res; 10
R5: res; 10
R6: res; 90k
R7: res; 10k
R8: res; 10k
R9: res; 10k
R10: res; 1000
R11: res; 1Meg
R12: res; 9k
R13: res; 1k
R14: res; 9k
R15: res; 1k
R16: res; 90k
R17: res; 90k
R18: res; 100k
R19: res; 10k
R20: res; 100k
R21: res; 10k
R22: res; 1k
R23: res; 1k
R24: res; 4k
R25: res; 6k
R26: res; 3.3k
R27: res; 8.2k
RD1: res; 10
Rs: res; 0.1
U1: UniversalOpamp2; Avol=1Meg GBW=100000Meg Slew=100000Meg
U4: UniversalOpamp2; Avol=1Meg GBW=100000Meg Slew=100000Meg
U5: UniversalOpamp2; Avol=1Meg GBW=100000Meg Slew=100000Meg
U7: UniversalOpamp2; Avol=1Meg GBW=100000Meg Slew=100000Meg
V1: voltage; 15
V2: voltage; 15
V3: voltage; PULSE(-1 1 0 2.5u 2.5u 0 5u)
V4: voltage; SINE(0 1 1k)
V5: voltage; 15
V6: voltage; PULSE(-0.5 0.5 0 1m 1m 0 2m)
V7: voltage; 2.5
V8: voltage; PULSE(50 60 1m 1u 1u 100m 100m 1)
X1: IRS20954
Named nets: 15V, 0, -15V, V+, Vo, Vf, VrefV, V_salida, VerrorC, V_triang, V_error, V_limite_C, PWM_out, Vin1
.model SW SW(Ron=0.001 Roff=100Meg Vt=0.5 Vh=0.25)
.tran 0 30m 0 1u uic
.include irf6665.spi
.model SWC SW(Ron=0.1 Roff=100Meg Vt=0.5 Vh=0.25)
