crpistillo/ProyectoDCE/ETAPA_POTENCIA/irs20954/Draft1.asc

V1: voltage; PULSE(-5 5 0 20u 20u 0.001u 40u)
V2: voltage; PULSE(-1 1 0 1m 1m 0.001m 2m)
Named nets: 0, Triangular, Señal
.tran 4m
