crpistillo/ProyectoDCE/PRACTICAS/Actividad5/PrimeraEtapa.asc

I1: current; 10m
Q1: npn; BC338
Q2: pnp; BC328
R1: res; 200
R2: res; 10
R3: res; 1.65k
R4: res; 250
R5: res; 10
Named nets: 0
.tran 5
.MODEL BC338 NPN (IS=0.180P NF=1.000 BF=449.302 VAF=95.000 IKF=0.820 
+ ISE=8.480F NE=1.566 NR=1.005 BR=16.919 VAR=13.000 IKR=0.663 
+ ISC=0.102P NC=1.764 
+ RB=0.750 IRB=0.100M RBM=0.375 
+ RE=0.170 RC=0.289 
+ CJE=63.400P VJE=0.850 MJE=0.372 FC=0.750 
+ CJC=16.600P VJC=0.780 MJC=0.433 XCJC=0.650 
+ TF=0.810N TR=2.600N PTF=1.000 
+ XTF=4.300 VTF=1.500 ITF=0.450 
+ XTB=1.500 EG=1.110 XTI=4.800 
+ KF=5.000F AF=1.000)
.MODEL BC328 PNP (IS=0.230P NF=1.000 BF=504.327 VAF=26.000 IKF=0.780 
+ ISE=39.284F NE=1.944 NR=1.002 BR=23.000 VAR=4.500 IKR=0.195 
+ ISC=0.118F NC=3.025 
+ RB=0.800 IRB=0.100M RBM=0.400 
+ RE=0.203 RC=0.262 
+ CJE=57.177P VJE=1.000 MJE=0.470 FC=0.750 
+ CJC=28.600P VJC=1.000 MJC=0.520 XCJC=0.650 
+ TF=0.664N TR=2.600N PTF=1.000 
+ XTF=6.350 VTF=2.000 ITF=0.250 
+ XTB=1.700 EG=1.110 XTI=4.800 
+ KF=5.000F AF=1.000)
