crpistillo/ProyectoDCE/Kicad/Etapa_de_potencia/Etapa_de_potencia_final.kicad_pcb

## KiCad design Kicad/Etapa_de_potencia/Etapa_de_potencia_final.kicad_pcb (2020-08-29)

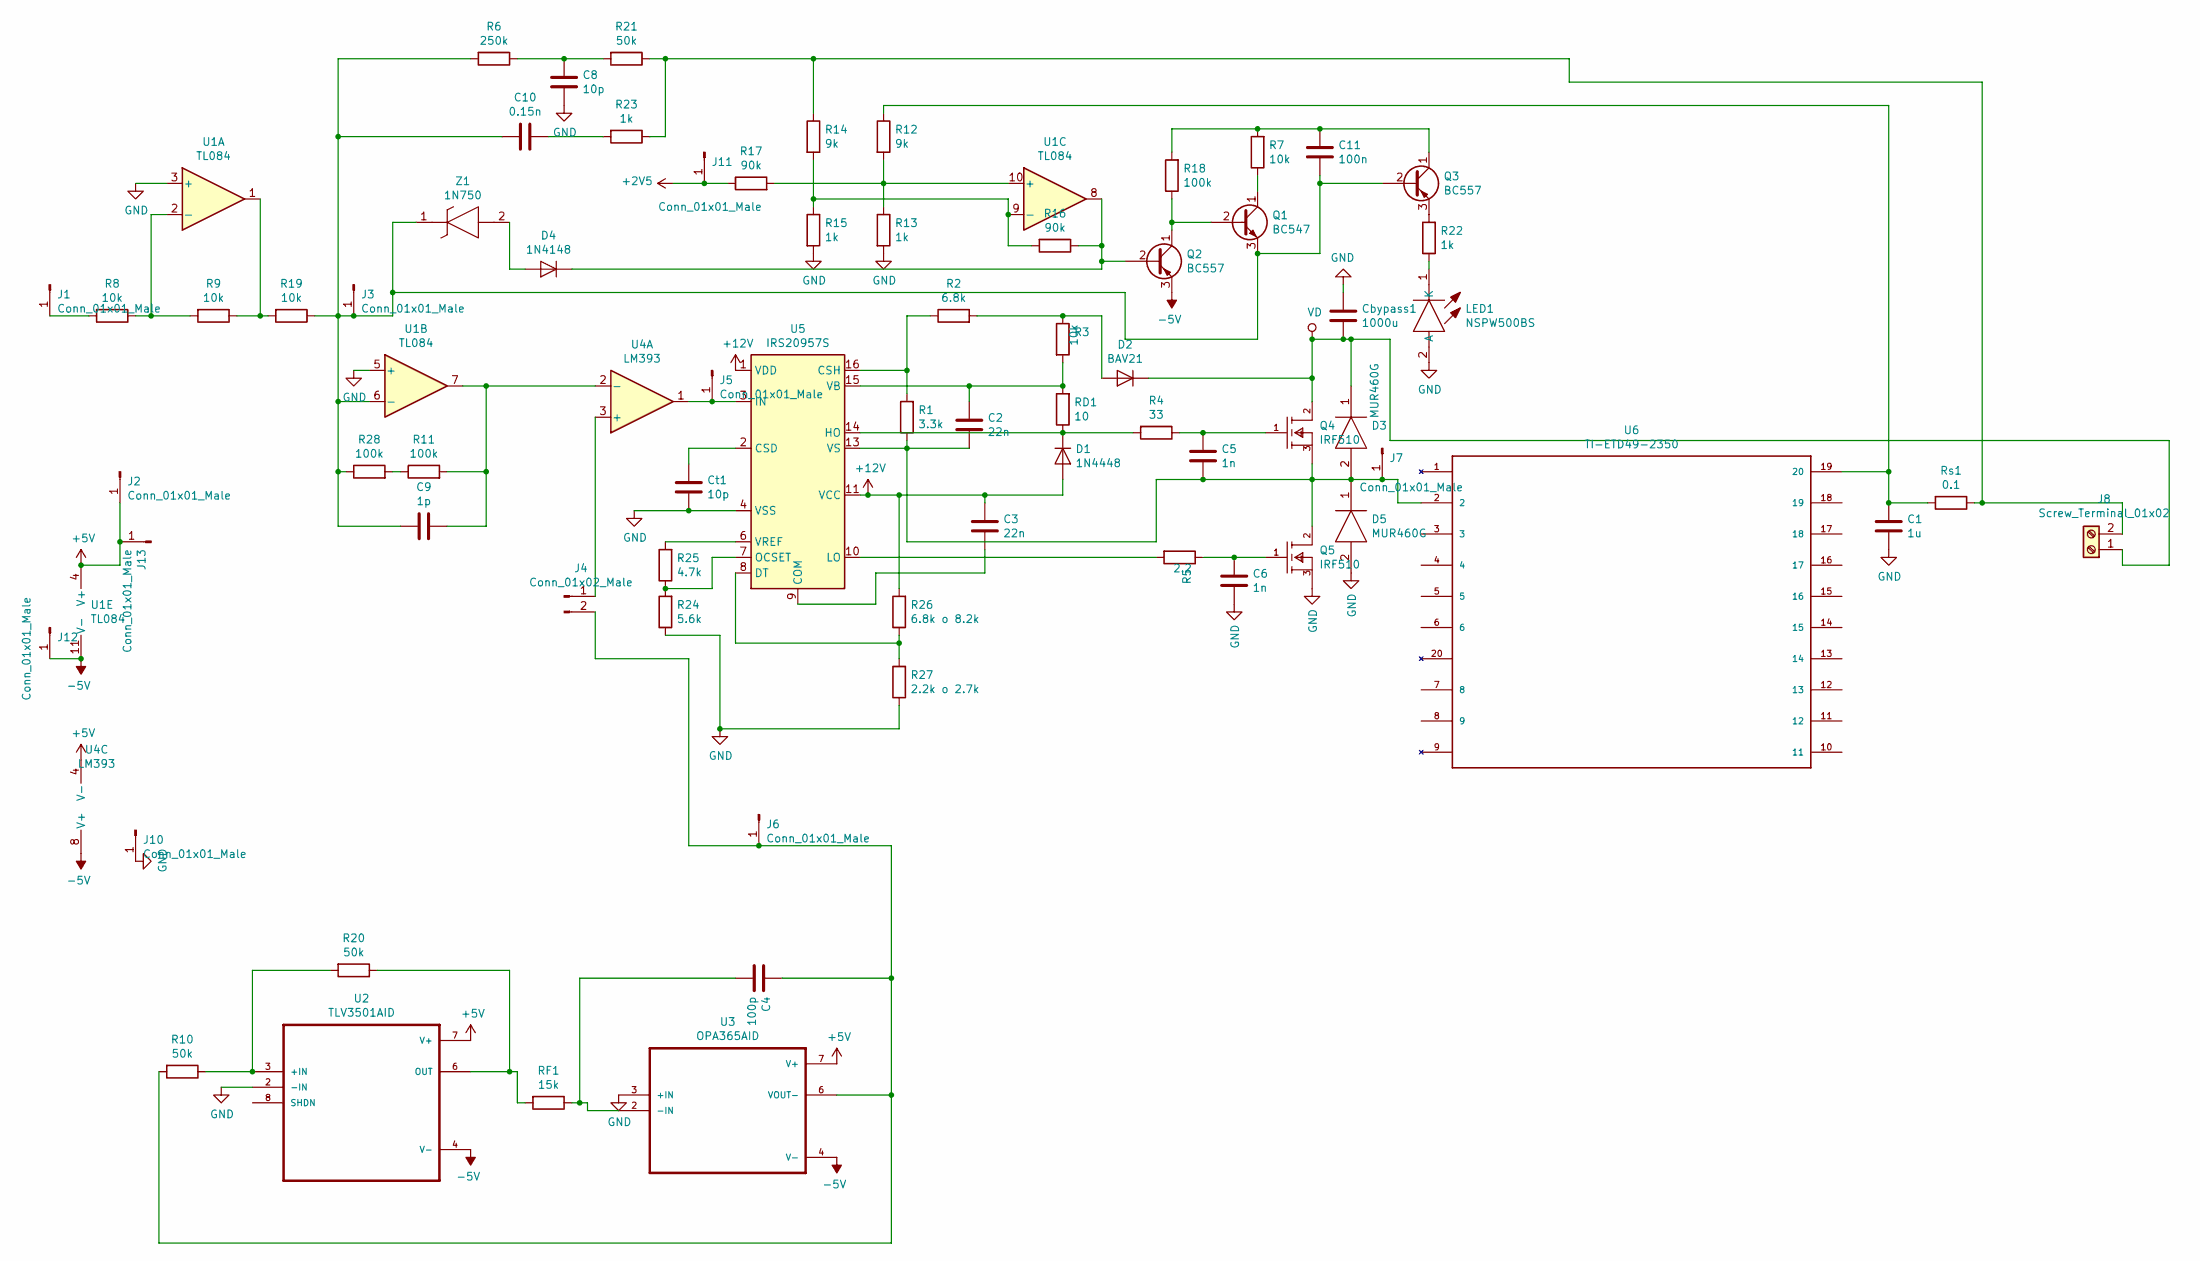
[picture p37: schematic Etapa_de_potencia_final.sch]

Parts:
C1: 1u; C_Radial_D5.0mm_H11.0mm_P2.00mm
C2, C3: 22n; C_1206_3216Metric
C4: 100p; C_1206_3216Metric
C5, C6: 1n; C_1206_3216Metric
C8: 10p; C_1206_3216Metric
C9: 1p; C_Disc_D8.0mm_W5.0mm_P5.00mm
C10: 0.15n; C_0805_2012Metric
C11: 100n; C_0603_1608Metric
Cbypass1: 1000u; C_Radial_D16.0mm_H25.0mm_P7.50mm
Ct1: 10p; C_1206_3216Metric
D1: 1N4448; D_DO-35_SOD27_P7.62mm_Horizontal
D2: BAV21; D_DO-35_SOD27_P7.62mm_Horizontal
D3, D5: MUR460G; DIOAD2860W130L840D505; Manufacturer_Part_Number MUR460G; Mouser Part Number 863-MUR460G
D4: 1N4148; D_DO-35_SOD27_P7.62mm_Horizontal
J1, J2, J3, J5, J6, J7, J10, J11, J12, J13: Conn_01x01_Male; PinHeader_1x01_P1.00mm_Vertical
J4: Conn_01x02_Male; PinHeader_1x02_P1.00mm_Vertical
J8: Screw_Terminal_01x02; TerminalBlock_bornier-2_P5.08mm
LED1: NSPW500BS; Manufacturer_Part_Number NSPW500BS
Q1: BC547; TO-92_Inline
Q2, Q3: BC557; TO-92_Inline
Q4, Q5: IRF510; Vishay-IRF510-0; mouser part number 844-IRF510; digikey description MOSFET N-CH 100V 5.6A TO-220AB
R1: 3.3k; R_0603_1608Metric
R2: 6.8k; R_0603_1608Metric
R3, R7, R8, R9, R19: 10k; R_0603_1608Metric
R4: 33; R_Axial_DIN0309_L9.0mm_D3.2mm_P2.54mm_Vertical
R5: 2.2; R_Axial_DIN0309_L9.0mm_D3.2mm_P2.54mm_Vertical
R6: 250k; R_0603_1608Metric
R10, R20, R21: 50k; R_0603_1608Metric
R11, R18, R28: 100k; R_0603_1608Metric
R12, R14: 9k; R_0603_1608Metric
R13, R15, R22, R23: 1k; R_0603_1608Metric
R16, R17: 90k; R_0603_1608Metric
R24: 5.6k; R_0603_1608Metric
R25: 4.7k; R_0603_1608Metric
R26: 6.8k o 8.2k; R_0603_1608Metric
R27: 2.2k o 2.7k; R_0603_1608Metric
RD1: 10; R_0603_1608Metric
RF1: 15k; R_0603_1608Metric
Rs1: 0.1; R_0603_1608Metric
U1: TL084; SOIC-14_3.9x8.7mm_P1.27mm
U2: TLV3501AID; SOIC127P599X175-8N
U3: OPA365AID; SOIC127P599X175-8N
U4: LM393; SOIC-8_3.9x4.9mm_P1.27mm
U5: IRS20957S; SOIC-16_3.9x9.9mm_P1.27mm
U6: TI-ETD49-2350; ETD49-K-H-20P
Z1: 1N750; DIOAD1256W56L444D203; Manufacturer_Part_Number 1N750; Mouser Part Number 494-1N750(DO-35)

Connections:
+2V5: J11.1, R17.1
+5V: J2.1, J13.1, U1.4 (V+), U2.7 (V+), U3.7 (V+), U4.4 (V-)
+12V: C3.2, D1.2 (A), R26.2, U5.1 (VDD), U5.11 (VCC)
-5V: J12.1, Q2.3 (E), U1.11 (V-), U2.4 (V-), U3.4 (V-), U4.8 (V+)
GND: C1.2, C6.2, C8.1, Cbypass1.2, Ct1.1, D5.2, J10.1, LED1.2 (A), Q5.3 (S), R13.2, R15.2, R24.1, R27.1, U1.3 (+), U1.5 (+), U2.2 (-IN), U3.3 (+IN), U5.4 (VSS)
unnamed: C1.1, R12.1, Rs1.2, U6.19 (20)
unnamed: C2.1, C5.2, D3.2, D5.1, J7.1, Q4.3 (S), Q5.2 (D), R1.1, U5.13 (VS), U6.2
unnamed: C2.2, R3.2, RD1.2, U5.15 (VB)
unnamed: C3.1, U5.9 (COM)
unnamed: C4.1, RF1.1, U3.2 (-IN)
unnamed: C4.2, J4.2, J6.1, R10.2, U3.6 (VOUT-)
unnamed: C5.1, Q4.1 (G), R4.1
unnamed: C6.1, Q5.1 (G), R5.1
unnamed: C8.2, R6.1, R21.2
unnamed: C9.1, R11.2, U1.7, U4.2 (-)
unnamed: C9.2, C10.1, C11.1, J3.1, Q1.3 (E), Q3.2 (B), R6.2, R19.1, R28.1, U1.6 (-), Z1.1
unnamed: C10.2, R23.2
unnamed: C11.2, Q3.1 (C), R7.2, R18.2
unnamed: Ct1.2, U5.2 (CSD)
unnamed: D1.1 (K), R4.2, RD1.1, U5.14 (HO)
unnamed: D2.2 (A), R2.2, R3.1
unnamed: D4.1 (K), Q2.2 (B), R16.1, U1.8
unnamed: D4.2 (A), Z1.2
unnamed: J1.1, R8.2
unnamed: J4.1, U4.3 (+)
unnamed: J5.1, U4.1, U5.3 (IN)
unnamed: J8.2, R14.1, R21.1, R23.1, Rs1.1
unnamed: LED1.1 (K), R22.1
unnamed: Q1.1 (C), R7.1
unnamed: Q1.2 (B), Q2.1 (C), R18.1
unnamed: Q3.3 (E), R22.2
unnamed: R1.2, R2.1, U5.16 (CSH)
unnamed: R5.2, U5.10 (LO)
unnamed: R8.1, R9.2, U1.2 (-)
unnamed: R10.1, R20.2, U2.3 (+IN)
unnamed: R11.1, R28.2
unnamed: R12.2, R13.1, R17.2, U1.10 (+)
unnamed: R14.2, R15.1, R16.2, U1.9 (-)
unnamed: R9.1, R19.2, U1.1
unnamed: R20.1, RF1.2, U2.6 (OUT)
unnamed: R24.2, R25.1, U5.7 (OCSET)
unnamed: R25.2, U5.6 (VREF)
unnamed: R26.1, R27.2, U5.8 (DT)
VD: Cbypass1.1, D2.1 (K), D3.1, J8.1, Q4.2 (D)

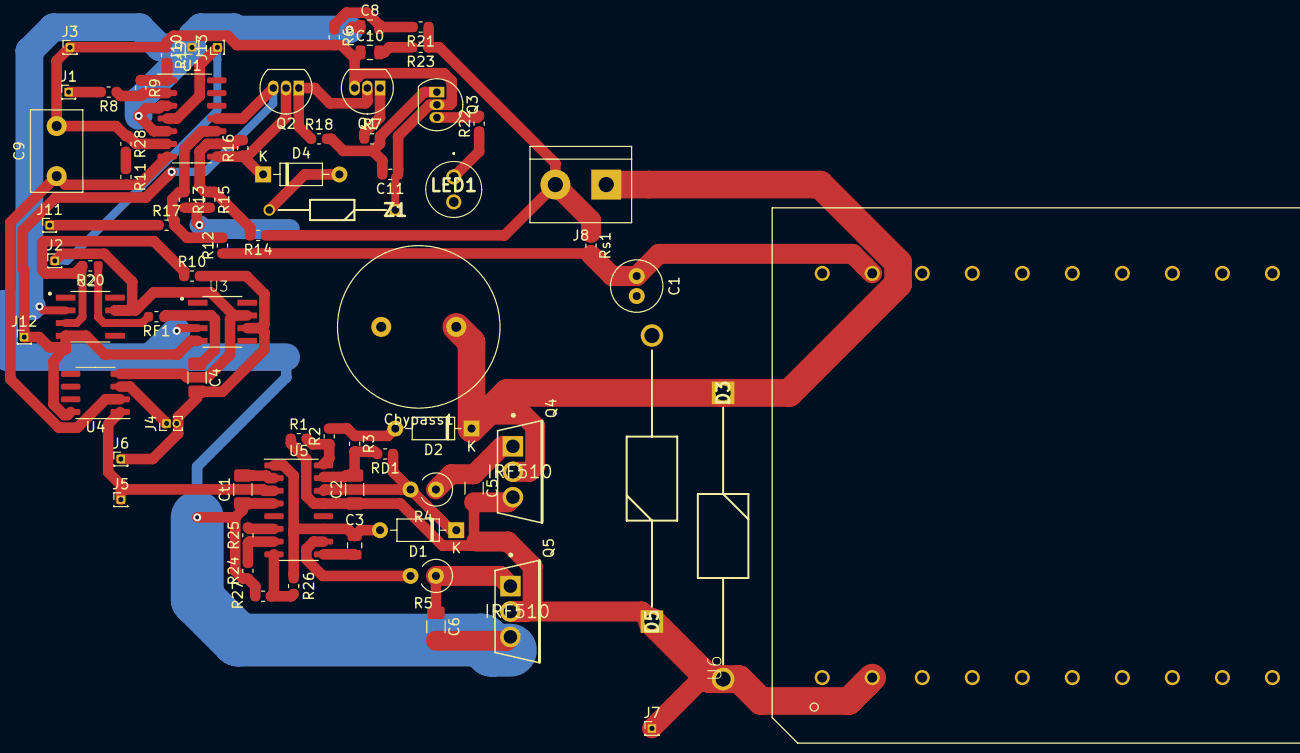
[picture p38: board Etapa_de_potencia_final.kicad_pcb from above]

Board: 2 copper layers, 73 parts (0 on the bottom side), 44 nets.
