crpistillo/ProyectoDCE/Kicad/Etapa_unica_control/etapa_unica_control.kicad_pcb

## KiCad design Kicad/Etapa_unica_control/etapa_unica_control.kicad_pcb (2020-07-14)

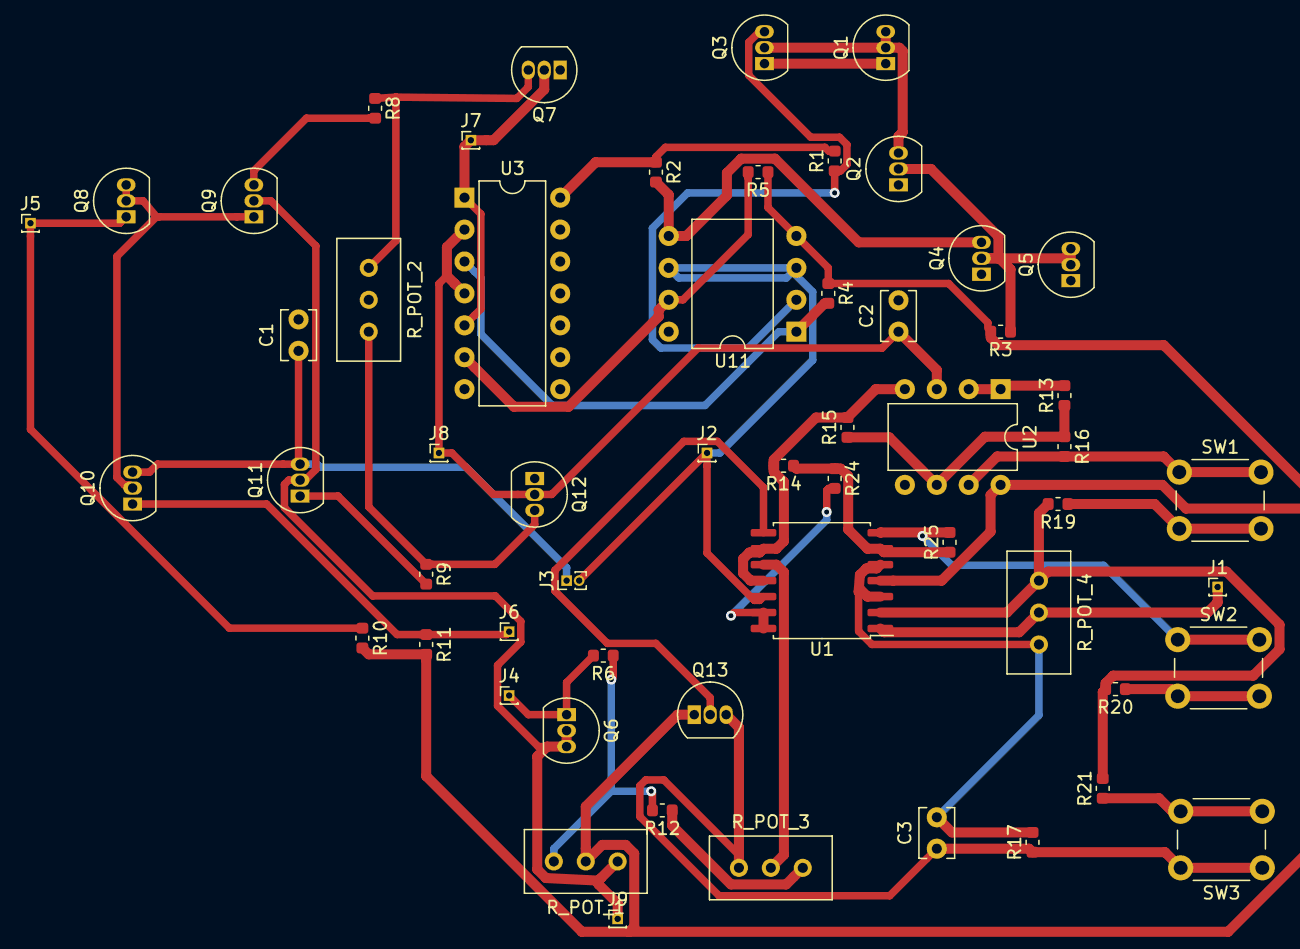
[picture p39: board etapa_unica_control.kicad_pcb from above]

Board: 2 copper layers, 57 parts (0 on the bottom side), 39 nets.

Parts:
C1: 200n; C_Disc_D3.8mm_W2.6mm_P2.50mm
C2: 0.1u; C_Disc_D3.8mm_W2.6mm_P2.50mm
C3: 0.01u; C_Disc_D3.8mm_W2.6mm_P2.50mm
J1, J2, J4, J5, J6, J7, J8, J9: Conn_01x01_Male; PinHeader_1x01_P1.00mm_Vertical
J3: Conn_01x02_Male; PinHeader_1x02_P1.00mm_Vertical
Q1, Q3, Q8, Q9, Q10: 2N3906; TO-92_Inline
Q2, Q4, Q5, Q6, Q11: 2N3904; TO-92_Inline
Q7, Q12: 2N7000; TO-92_Inline
Q13: BS250; TO-92_Inline
R1, R2: 500; R_0603_1608Metric
R3, R16, R17, R21: 10K; R_0603_1608Metric
R4, R5: 3K; R_0603_1608Metric
R6, R8, R9, R14, R19, R20, R24, R25: 10k; R_0603_1608Metric
R10, R11: 100; R_0603_1608Metric
R12: 100K; R_0603_1608Metric
R13: 20k; R_0603_1608Metric
R15: 40k; R_0603_1608Metric
R_POT_1: 500K; Potentiometer_Bourns_3296W_Vertical
R_POT_2: 50K; Potentiometer_Bourns_3296W_Vertical
R_POT_3: 200K; Potentiometer_Bourns_3296W_Vertical
R_POT_4: 20K; Potentiometer_Bourns_3296W_Vertical
SW1, SW2, SW3: SW_DIP_x01; SW_PUSH_6mm
U1: TL084; SOIC-14W_7.5x9mm_P1.27mm
U2: TL082; DIP-8_W7.62mm
U3: 74HC02; DIP-14_W7.62mm
U11: LM393; DIP-8_W10.16mm

Connections:
+5V: R1.2, R2.1, U3.14
+15V: Q13.1, R3.2, R4.1, R5.1, R10.2, R11.2, R_POT_1.2, U1.4, U2.8, U11.4
-5V: R14.2, R15.2, U1.9, U1.11, U2.4
GND: C1.2, C2.2, C3.2, Q2.1, Q4.1, Q5.1, Q7.1, Q12.1, R6.1, R12.2, R17.2, R_POT_1.1, R_POT_2.2, R_POT_4.1, U1.3, U1.5, U2.5, U3.7, U11.8
unnamed: C1.1, J3.1, Q10.3, Q11.3
unnamed: C2.1, J8.1, Q12.2, U2.3, U3.2, U3.4
unnamed: C3.1, Q13.3, R17.1, R_POT_3.3, SW3.1
unnamed: J2.1, J3.2, U1.12, U11.3, U11.6
unnamed: J4.1, Q6.1, R6.2
unnamed: J5.1, Q8.1, R10.1
unnamed: J6.1, Q10.1, R11.1
unnamed: J7.1, Q7.2, U3.1, U3.5
unnamed: J9.1, Q6.2, Q6.3, Q9.2, Q11.2, R_POT_1.3
unnamed: Q1.1, Q3.1
unnamed: Q1.2, Q1.3, Q2.3, Q3.2
unnamed: Q2.2, Q4.2, Q5.2, Q5.3, R3.1
unnamed: Q3.3, R1.1, U11.2
unnamed: Q4.3, R2.2, U11.5
unnamed: Q7.3, R8.1, R_POT_2.3
unnamed: Q9.3, R8.2
unnamed: Q8.2, Q8.3, Q9.1, Q10.2
unnamed: Q11.1, R9.2
unnamed: Q12.3, R9.1, R_POT_2.1
unnamed: Q13.2, U1.8
unnamed: R4.2, U3.3, U11.1
unnamed: R5.2, U3.6, U11.7
unnamed: R12.1, R_POT_3.1
unnamed: R13.1, R15.1, R16.1, U2.6
unnamed: R13.2, U2.1, U2.2
unnamed: R14.1, R24.1, R25.1, U1.6
unnamed: R16.2, SW1.1, U2.7
unnamed: R19.1, SW1.2
unnamed: R19.2, R20.2, R21.2, R_POT_4.3, U1.2
unnamed: R20.1, SW2.2
unnamed: R21.1, SW3.2
unnamed: R24.2, U1.13, U1.14
unnamed: R25.2, SW2.1, U1.7
unnamed: R_POT_3.2, U1.10
Vout: J1.1, R_POT_4.2, U1.1
