crpistillo/ProyectoDCE/(commit log)

2020-04-14 Create hola123.txt
    Agregue el hola123 para dejar un saludo.
2020-04-16 Onda cuadrada y triangular
    ejemplos copiados del RASHID.
    la triangular no funciona
2020-04-17 Onda cuadrada con LM555, presenta un pico
2020-04-20 Modelo y circuito con LM741
2020-04-20 reemplace el EJERCICIO1
    a
2020-04-24 7.5V pp en triangular
2020-04-24 Ejercicio 1 Vst=5
    Disparador schmitt centrado en 5 v
2020-04-26 7.4V Pico
2020-05-01 Agrego carpeta Datasheets
    Con la del LM111
2020-05-10 Posible circuito tp1
2020-05-14 Circuito
    Dudas: como centrar en cero la triangular ya que el capacitor no logra tener tensiones negativas.
2020-05-15 Definitivo
    De esos tres hay que sacar uno que tenga el duty y la frecuencia
2020-05-15 Con POTs para duty y frec
2020-05-20 Definitivo
    Circuit definitivo
2020-05-22 Saque un par de resistencias y la fuente de 6V
2020-05-23 Circuito definitivo
2020-05-23 Regulador
    Regulador con limitador de corriente
2020-05-23 Regulador20V
    Regulador con 20V a la salida y 60V a la entrada
2020-05-23 Salida de 15v
2020-05-23 Suma de señales cuadrada DC y triangular
2020-05-25 saque uno que no iba
2020-05-26 Correccion del sumador, R19,R20(baje la dc para que no sature el sumador) y R11(la salida de la cuadrada esta muy alta , la baje)
2020-05-28 cambio mosfet por modelo
2020-05-28 DC ok
    Cambie Vcc-5 por V-5 lo mismo para la positiva.
    Tambien acomode la entrada al sumador( dejando las R=10k conectadas a este subcircuito.
    Por ultimo aclaro que la salida de la DC ahora queda en 0v si se cambia R19 y R20 que es el pot del offset se varia la continua
2020-05-28 flip-flop 15 V
2020-05-29 Acoplo continua correcta a CIRCUITO_FINAL_PROLIJO
2020-06-05 regulador de menor tension y mayor rango de regulacion
2020-06-12 RegDePotencia es el regulador lineal con darlingotn de potencia
2020-06-12 Regulador Potencia (sin el Limitador)
    El LM7815 en la etapa de control tiene una corriente de entrada MUY grande
2020-06-17 circuitos actividad5
2020-06-18 Kicad etapa de control
    [etapa_control.kicad_pcb, etapa_control.sch, etapa_de_control_bis.kicad_pcb]
2020-06-18 KiCad reguladores
    [reguladores.kicad_pcb, reguladores.sch]
2020-06-26 Relay ideal, step up ideal
2020-07-10 Kicad, etapa de control
    [Etapa_de_contro_2.kicad_pcb, Etapa_de_control_1.kicad_pcb, Etapa_de_control_1.sch, Etapa_de_control_2.sch, etapa_control.kicad_pcb, etapa_control.sch, etapa_control_final.kicad_pcb, etapa_de_control_bis.kicad_pcb]
2020-07-11 Correccion, GND
2020-07-13 kicad 1 sola placa, etapa de control
    [Etpa_unica_control.sch, etapa_unica_control.kicad_pcb]
2020-07-17 Idea de bertuccio
2020-07-18 Probando filtro LC en salida de halfbridge
2020-07-23 Actualizacion etapa potencia
    Joaco, ahi pude arreglar el problema era de las huellas que las habia descargado mal. acomode muy por arriba los componentes en el kicad ma;ana nos ponemos a ubicarlos el el lugar especifico
    [1N750.stl, 1N750.stp, EDI2CAP.CFG, EtapaPotencia.kicad_pcb, EtapaPotencia.sch, IRF630.stl, IRF630.stp, MUR460G.stl]
2020-07-23 Actualizacion PCB
    Falta acomodar el GND y ver los Loops
    [EtapaPotencia.dsn, EtapaPotencia.kicad_pcb, EtapaPotencia.sch]
2020-07-28 cambio en huellas del kikad
    [EtapaPotencia.sch]
2020-07-30 Circuito prolijo
2020-07-30 Reacomodaciones en la carpeta de kicad, y se subio el PCB de la etapa de potencia
    [1N750.stl, 1N750.stp, EDI2CAP.CFG, EtapaPotencia.dsn, EtapaPotencia.kicad_pcb, EtapaPotencia.sch, Etapa_de_potencia_final.kicad_pcb, Etapa_de_potencia_final.sch]
2020-07-30 modelos de footprints
    [1N750.stl, 1N750.stp, EDI2CAP.CFG, IRF630.stl, IRF630.stp, MUR460G.stl, MUR460G.stp, NSPW500BS.stl]
2020-08-08 Limitador Funcionando
    Circuito final con limitador
2020-08-12 driver arreglado
2020-08-14 Kicad Circuito de potencia FINAL
2020-08-25 PCB FINAL POTENCIA
    [Etapa_de_potencia_final.kicad_pcb, Etapa_de_potencia_final.sch]
2022-01-11 Actualizo circuito final: posible_circuito_potencia..
